reparationchlorinateur/gree-bridge/docs/captures/protocol_b_defrost.txt

# Protocol B (1200 baud 8E1): a whole defrost cycle, Willis MGW12KCH15S/I (made by Gree), heating at Heat 26,
# about -2 C outside, 2026-11-13. Bridge RX tap (BusLog 1), one line when a watched byte changed or every ~15 s.
# Columns: time, outdoor 31 10 frame, indoor 31 20 frame, outdoor 32 10 frame (all 20 bytes, last byte = sum).
#
# Normal heat just before (08:13, from the board's "Out" field, b3..b18 of 31 10):
#   14 58 00 00 24 00 00 5C 00 26 20 86 00 00 09 00   (88 Hz, outdoor air -2, outdoor coil -8, discharge 94, b15 00, b17 09)
#   indoor fan 4, indoor coil 35 C, indoor b12 0A
#
# Defrost was already running when the capture started (08:28 the board showed b15 = 02 and a falling indoor coil).
# What marks it:  outdoor b15 = 02 from the start of defrost until the compressor restarts in heat;
#                 indoor coil falls below 0 (down to -19 C: reversed cycle), indoor fan b4 = 00, indoor b12 = 00;
#                 outdoor coil warms from -8 to +16 C while the compressor holds 85 Hz; the outdoor "air" byte
#                 reads up to +17 C (its sensor is warmed by the coil), b17 falls to 3-6 then 0.
# End: 08:32:35 compressor stops (b3 04, b15 still 02), 08:34:07 indoor b12 back to 08, 08:34:26 compressor
#      restarts in heat at 33 Hz with b15 = 00, 08:36:07 indoor fan back on (coil 16 C), b12 0A.
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
08:36:11  31 10 00 14 21 00 00 0C 00 00 50 00 2B 27 5E 00 00 02 00 84  31 20 00 14 01 00 42 3C 00 39 07 00 0A 00 00 00 00 00 00 2E  32 10 00 00 00 00 00 00 00 00 00 00 46 00 00 28 28 28 28 28
