reparationchlorinateur/gree-bridge/docs/images/willis_mgw12kch15s_label.jpg

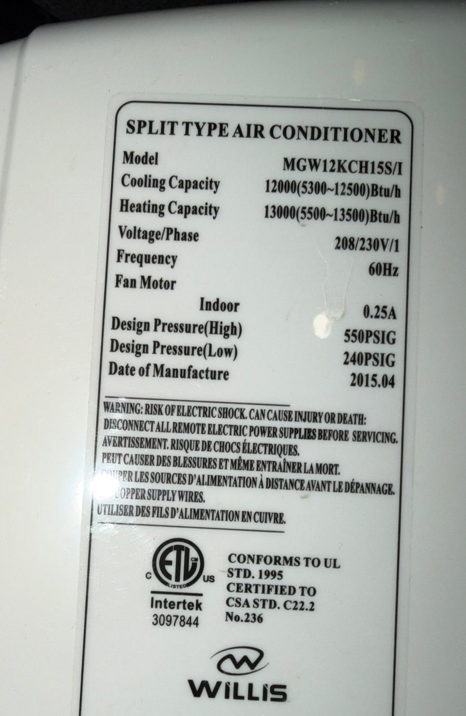
docs/images/willis_mgw12kch15s_label.jpg
