reparationchlorinateur/gree-bridge/hardware/case/out/png/gree_base_top_board.png

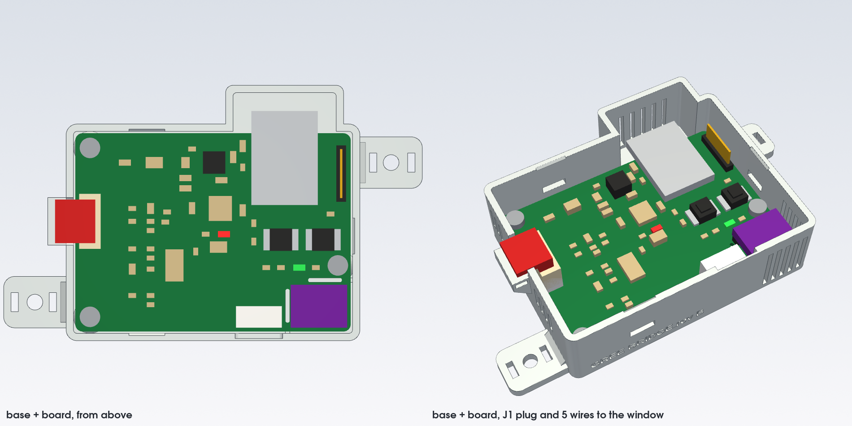
hardware/case/out/png/gree_base_top_board.png
