reparationchlorinateur/gree-bridge/hardware/case/out/png/gree_case_exploded.png

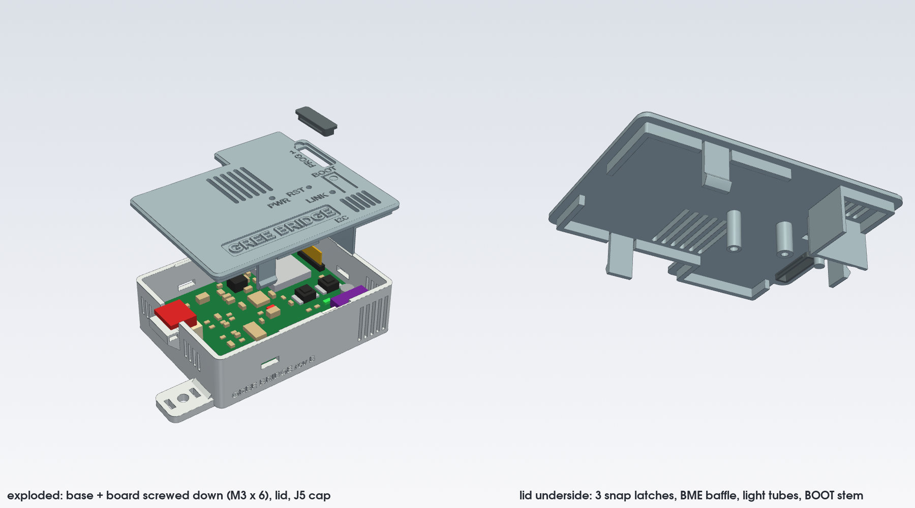
hardware/case/out/png/gree_case_exploded.png
