reparationchlorinateur/gree-bridge/hardware/case/out/png/gree_latch.png

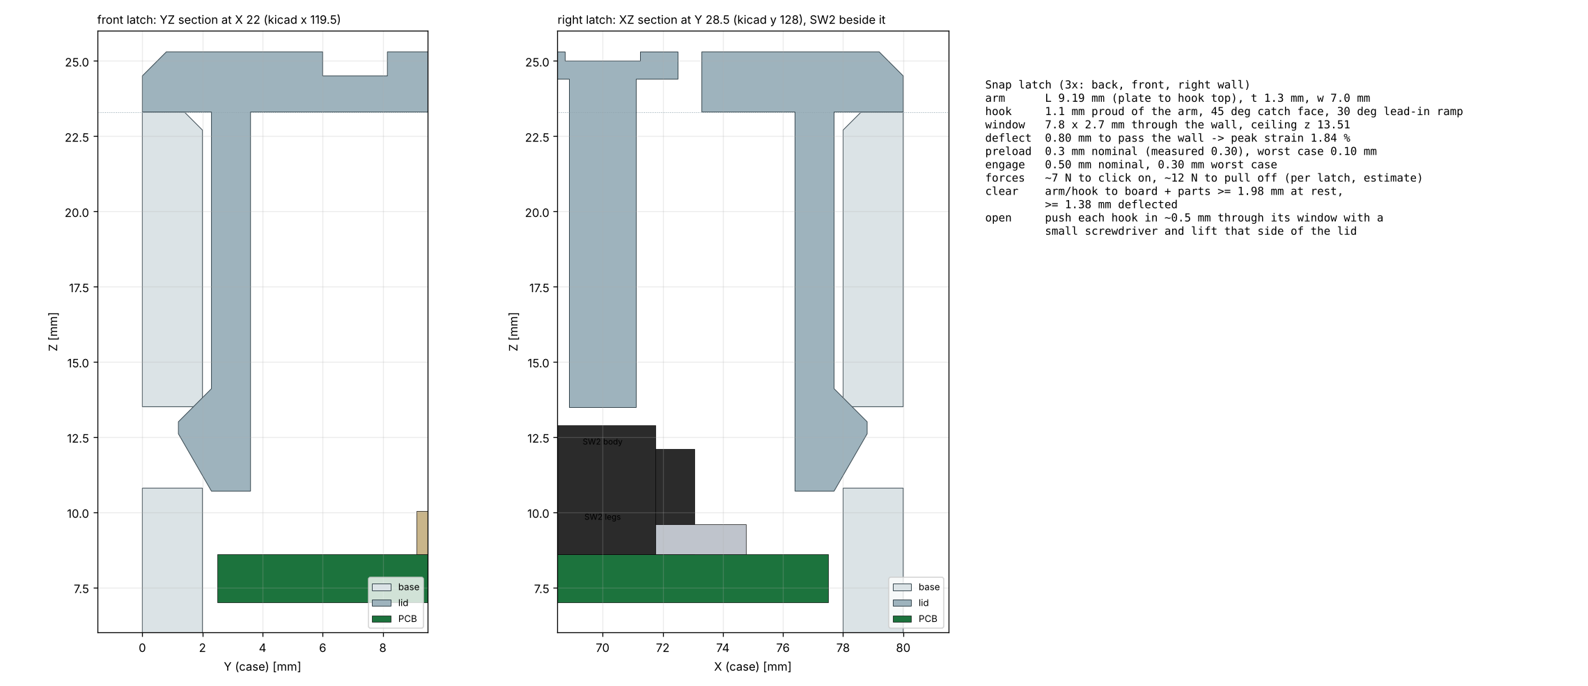
hardware/case/out/png/gree_latch.png
