reparationchlorinateur/gree-bridge/hardware/case/out/png/gree_latch_closeup.png

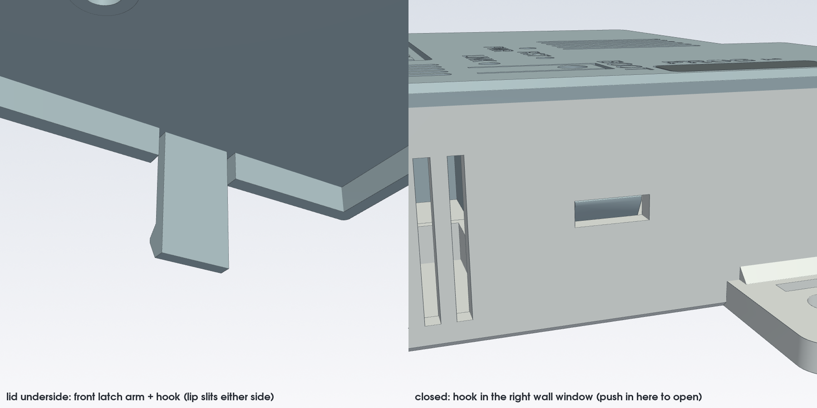
hardware/case/out/png/gree_latch_closeup.png
