reparationchlorinateur/gree-bridge/hardware/case/out/png/gree_lid_top.png

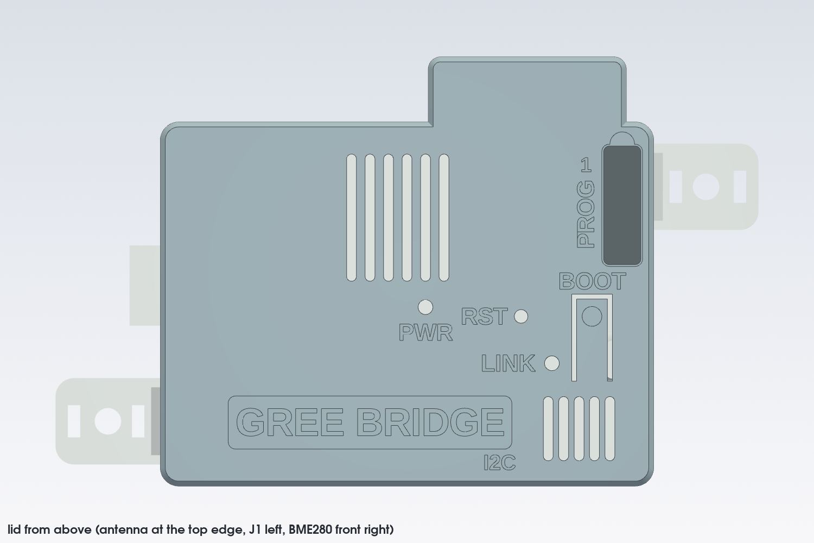
hardware/case/out/png/gree_lid_top.png
