reparationchlorinateur/gree-bridge/hardware/case/out/png/gree_section.png

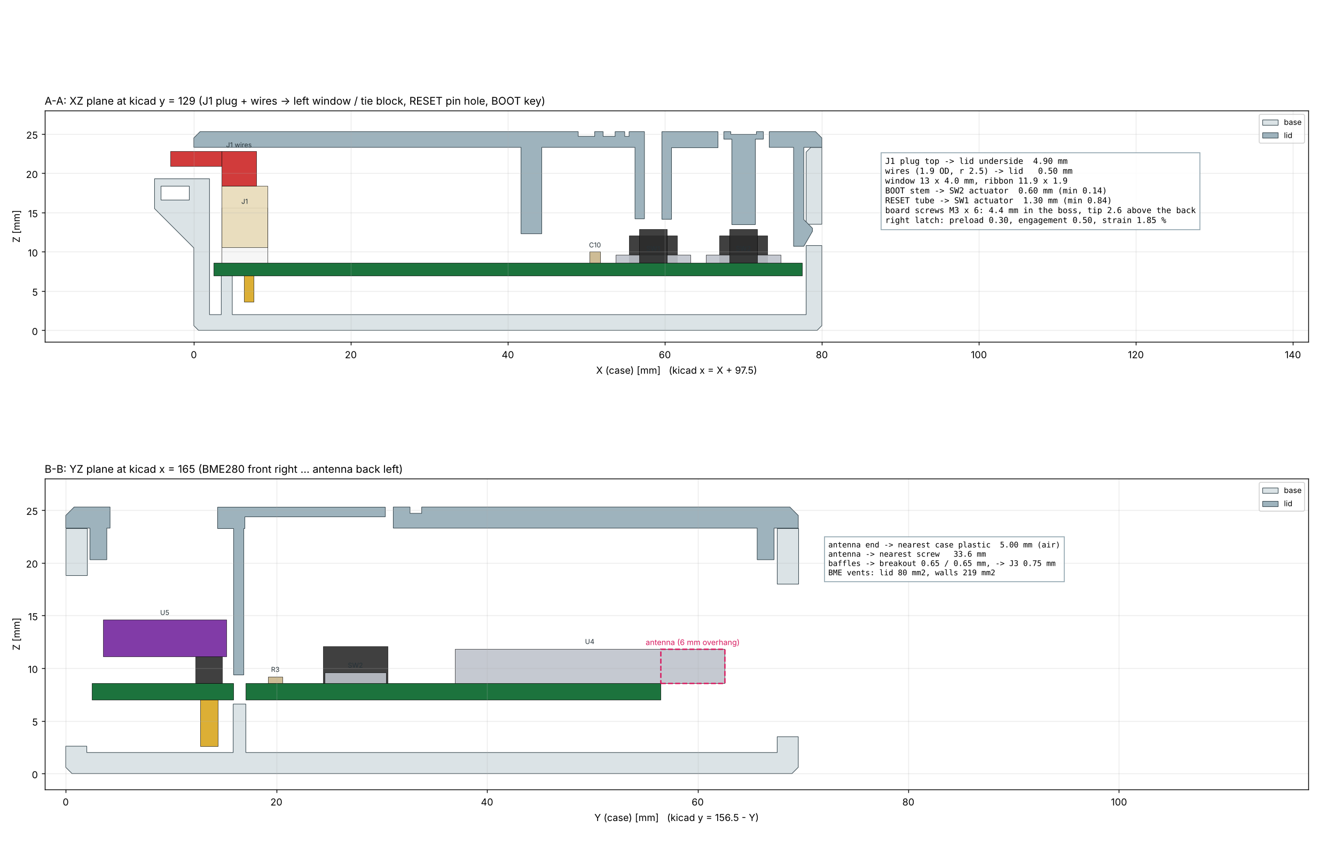
hardware/case/out/png/gree_section.png
