reparationchlorinateur/gree-bridge/hardware/bom.csv

Line | References | Qty per board | Value | Description | Manufacturer | Mfr part # | Mouser # | LCSC # (JLCPCB) | JLCPCB part | KiCad footprint | Notes
1 | C1 C2 C6 | 3 | 10uF 25V | MLCC 10 uF 25 V X7R 1206 | YAGEO | CC1206KKX7R8BB106 | 603-CC126KKX7R8BB106 | C14860 | 10uF 25V X7R 1206 Samsung CL31B106KAHNNNE [SUBSTITUTE] | Capacitor_SMD:C_1206_3216Metric_Pad1.33x1.80mm_HandSolder
2 | C3 C9 C11 | 3 | 100nF | MLCC 100 nF 50 V X7R 0805 | YAGEO | CC0805KRX7R9BB104 | 603-CC805KRX7R9BB104 | C49678 | 100nF 50V X7R 0805 YAGEO CC0805KRX7R9BB104 | Capacitor_SMD:C_0805_2012Metric_Pad1.18x1.45mm_HandSolder
3 | C4 C5 C7 C8 | 4 | 22uF 25V | MLCC 22 uF 25 V X5R 1206 | TDK | C3216X5R1E226M160AB | 810-C3216X5R1E226M | C12891 | 22uF 25V X5R 1206 Samsung CL31A226KAHNNNE [SUBSTITUTE] | Capacitor_SMD:C_1206_3216Metric_Pad1.33x1.80mm_HandSolder | 25 V part keeps more of its capacitance at 5 V than a 10 V one
4 | C10 | 1 | 1uF | MLCC 1 uF 25 V X7R 0805 | YAGEO | CC0805KKX7R8BB105 | 603-CC805KKX7R8BB105 | C28323 | 1uF 50V X7R 0805 Samsung CL21B105KBFNNNE [SUBSTITUTE] | Capacitor_SMD:C_0805_2012Metric_Pad1.18x1.45mm_HandSolder
5 | C12 C13 C14 | 3 | 100pF | MLCC 100 pF 50 V C0G 0805 | YAGEO | CC0805JRNPO9BN101 | 603-CC805JRNPO9BN101 | C1790 | 100pF 50V C0G 0805 Samsung CL21C101JBANNNC [SUBSTITUTE] | Capacitor_SMD:C_0805_2012Metric_Pad1.18x1.45mm_HandSolder
6 | D1 D2 | 2 | SS14 | Schottky diode 40 V 1 A, SMA | onsemi | SS14 | 512-SS14 | C2480 | SS14 40V 1A SMA MDD SS14 [SUBSTITUTE] | Diode_SMD:D_SMA_Handsoldering
7 | D3 | 1 | GREEN | LED green (AlInGaP, 35 mcd), 1206 (status) | Lite-On | LTST-C150KGKT | 859-LTST-C150KGKT | C125085 | LED green 1206 Lite-On LTST-C150KGKT | LED_SMD:LED_1206_3216Metric_Pad1.42x1.75mm_HandSolder | Brighter AlInGaP green; about 1.5 mA from GPIO21 through R3 (1k)
8 | D4 | 1 | RED | LED red, 1206 (power) | Lite-On | LTST-C150KRKT | 859-LTST-C150KRKT | C125086 | LED red 1206 Lite-On LTST-C150KRKT | LED_SMD:LED_1206_3216Metric_Pad1.42x1.75mm_HandSolder
9 | F1 | 1 | 0.5A 24V | PTC resettable fuse 0.5 A hold, 24 V max, 1206 | Bel Fuse | 0ZCJ0050AF2E | 530-0ZCJ0050AF2E | C883126 | PTC 0.5A hold 1A trip 1206 BHFUSE BSMD1206-050-30V [SUBSTITUTE] | Fuse:Fuse_1206_3216Metric_Pad1.42x1.75mm_HandSolder | 24 V rated for the 12 V rail (the 6 V 1206L050YR of the first draft was not)
10 | J1 | 1 | GREE | JST XH 5-pin vertical through-hole header, 2.50 mm (to the Gree board) | JST | B5B-XH-A(LF)(SN) | 306-B5BXHALFSN | C157991 | JST XH 5-pin vertical (THT) JST B5B-XH-A(LF)(SN) [THT - hand-solder or JLC THT option] | Connector_JST:JST_XH_B5B-XH-A_1x05_P2.50mm_Vertical
11 | J3 | 1 | I2C_EXT | JST XH 4-pin vertical through-hole header, 2.50 mm (I2C port for more sensors) | JST | B4B-XH-A(LF)(SN) | 306-B4BXHALFSN | C144395 | JST XH 4-pin vertical (THT) JST B4B-XH-A(LF)(SN) [THT - hand-solder or JLC THT option] | Connector_JST:JST_XH_B4B-XH-A_1x04_P2.50mm_Vertical
12 | J5 | 1 | PROG | Pin header 1x6 2.54 mm, straight, through-hole, gold (programming) | Wurth Elektronik | 61300611121 | 710-61300611121 | C5444523 | Pin header 1x6 2.54mm (THT) Wurth 61300611121 [THT - hand-solder or JLC THT option] | Connector_PinHeader_2.54mm:PinHeader_1x06_P2.54mm_Vertical | Plain straight header (6 mm mating pins, 3 mm solder tails); replaces the alternating-leg SMD header
13 | L1 | 1 | 4.7uH | Inductor 4.7 uH +/-20%, 27 mOhm, Isat 5.8 A, shielded 6 x 6 x 4.5 mm | TDK | VLS6045EX-4R7M | 810-VLS6045EX-4R7M | C307880 | 4.7uH 5.8A 6x6x4.5 TDK VLS6045EX-4R7M | Inductor_SMD:L_Bourns_SRN6045TA | Replaces Bourns SRN6045TA-4R7M (0 in stock on 2026-10-08); fits the same pads, no PCB change. The Bourns part still fits if you prefer it
14 | Q1 | 1 | BSS138 | N-MOSFET 50 V, SOT-23 (IR transmit) | onsemi | BSS138 | 512-BSS138 | C52895 | BSS138 SOT-23 onsemi BSS138 | Package_TO_SOT_SMD:SOT-23
15 | Q2 | 1 | BC847C | NPN 45 V 100 mA, SOT-23, hFE 420-800 (RX level stage) | onsemi | BC847CLT1G | 863-BC847CLT1G | C150094 | BC847C SOT-23 onsemi BC847CLT1G | Package_TO_SOT_SMD:SOT-23 | New in rev B: lets J1-3 take the low-voltage U6 opto output
16 | R1 R2 | 2 | 10k | Resistor 10k 1% 1/8 W 0805 | YAGEO | RC0805FR-0710KL | 603-RC0805FR-0710KL | C17414 | 10k 1% 0805 UNI-ROYAL 0805W8F1002T5E [SUBSTITUTE] | Resistor_SMD:R_0805_2012Metric_Pad1.20x1.40mm_HandSolder
17 | R3 R5 R12 | 3 | 1k | Resistor 1k 1% 1/8 W 0805 | YAGEO | RC0805FR-071KL | 603-RC0805FR-071KL | C17513 | 1k 1% 0805 UNI-ROYAL 0805W8F1001T5E [SUBSTITUTE] | Resistor_SMD:R_0805_2012Metric_Pad1.20x1.40mm_HandSolder
18 | R4 R14 R15 | 3 | 4.7k | Resistor 4.7k 1% 1/8 W 0805 | YAGEO | RC0805FR-074K7L | 603-RC0805FR-074K7L | C17673 | 4.7k 1% 0805 UNI-ROYAL 0805W8F4701T5E [SUBSTITUTE] | Resistor_SMD:R_0805_2012Metric_Pad1.20x1.40mm_HandSolder
19 | R6 R11 R13 | 3 | 1M | Resistor 1M 1% 1/8 W 0805 | YAGEO | RC0805FR-071ML | 603-RC0805FR-071ML | C17514 | 1M 1% 0805 UNI-ROYAL 0805W8F1004T5E [SUBSTITUTE] | Resistor_SMD:R_0805_2012Metric_Pad1.20x1.40mm_HandSolder
20 | R7 | 1 | 220 | Resistor 220 1% 1/8 W 0805 | YAGEO | RC0805FR-07220RL | 603-RC0805FR-07220RL | C17557 | 220 1% 0805 UNI-ROYAL 0805W8F2200T5E [SUBSTITUTE] | Resistor_SMD:R_0805_2012Metric_Pad1.20x1.40mm_HandSolder
21 | R8 | 1 | 100 | Resistor 100 1% 1/8 W 0805 | YAGEO | RC0805FR-07100RL | 603-RC0805FR-07100RL | C17408 | 100 1% 0805 UNI-ROYAL 0805W8F1000T5E [SUBSTITUTE] | Resistor_SMD:R_0805_2012Metric_Pad1.20x1.40mm_HandSolder
22 | R9 | 1 | 100k | Resistor 100k 1% 1/8 W 0805 | YAGEO | RC0805FR-07100KL | 603-RC0805FR-07100KL | C149504 | 100k 1% 0805 UNI-ROYAL 0805W8F1003T5E [SUBSTITUTE] | Resistor_SMD:R_0805_2012Metric_Pad1.20x1.40mm_HandSolder
23 | R10 | 1 | 47k | Resistor 47k 1% 1/8 W 0805 | YAGEO | RC0805FR-0747KL | 603-RC0805FR-0747KL | C17713 | 47k 1% 0805 UNI-ROYAL 0805W8F4702T5E [SUBSTITUTE] | Resistor_SMD:R_0805_2012Metric_Pad1.20x1.40mm_HandSolder | R10 is 47k now (was 1k): base resistor of Q2
24 | R16 | 1 | 22k | Resistor 22k 1% 1/8 W 0805 | YAGEO | RC0805FR-0722KL | 603-RC0805FR-0722KL | C17560 | 22k 1% 0805 UNI-ROYAL 0805W8F2202T5E [SUBSTITUTE] | Resistor_SMD:R_0805_2012Metric_Pad1.20x1.40mm_HandSolder | R16: Q2 collector pull-up
25 | SW1 SW2 | 2 | RESET / BOOT | Tact switch 6 x 6 mm SMD gull-wing, 4.3 mm, 1.3 N | C&K | PTS645SL43SMTR92 LFS | 611-PTS645SL43SMTR92 | C221880 | Tact 6x6 SMD 4.3mm C&K PTS645SM43SMTR92LFS [SUBSTITUTE] | Button_Switch_SMD:SW_SPST_PTS645 | SL = 1.3 N version of the PTS645SM43 (1.6 N, restricted availability); same footprint
26 | U1 | 1 | AP63205WU-7 | Buck regulator 5 V 2 A, TSOT-23-6 | Diodes Incorporated | AP63205WU-7 | 621-AP63205WU-7 | C2071056 | AP63205WU-7 buck 5V 2A Diodes Inc AP63205WU-7 | Package_TO_SOT_SMD:TSOT-23-6
27 | U2 | 1 | AP2114H-3.3TRG1 | LDO 3.3 V 1 A, SOT-223 | Diodes Incorporated | AP2114H-3.3TRG1 | 621-AP2114H-3.3TRG1 | C150716 | AP2114H-3.3TRG1 LDO Diodes Inc AP2114H-3.3TRG1 | Package_TO_SOT_SMD:SOT-223-3_TabPin2
28 | U3 | 1 | 74LVC14AD | Hex Schmitt-trigger inverter, SOIC-14 | Texas Instruments | SN74LVC14ADRG4 | 595-SN74LVC14ADRG4 | C133541 | SN74LVC14A SOIC-14 TI SN74LVC14ADR [ORDERABLE VARIANT] | Package_SO:SOIC-14_3.9x8.7mm_P1.27mm | Same TI part as SN74LVC14ADR (G4 = green package code); the plain ADR was on order only
29 | U4 | 1 | ESP32-S3-WROOM-1-N16R8 | ESP32-S3 module, 16 MB flash, 8 MB PSRAM | Espressif | ESP32-S3-WROOM-1-N16R8 | 356-ESP32S3WRM1N16R8 | C2913202 | ESP32-S3-WROOM-1-N16R8 Espressif ESP32-S3-WROOM-1-N16R8 | RF_Module:ESP32-S3-WROOM-1
30 | U5 | 1 | GY-BME280 | BME280 breakout module, 6-pin (VCC GND SCL SDA CSB SDO), 3.3 V version | generic | GY-BME280 |  |  |  | GreeBridge:BME280_Module_GY_1x06_P2.54mm | Not a JLCPCB part: plug-in breakout on a 1x6 header, chip side up; address 0x76
