reparationchlorinateur/gree-bridge/hardware/case/out/step/gree_case_assembly.step

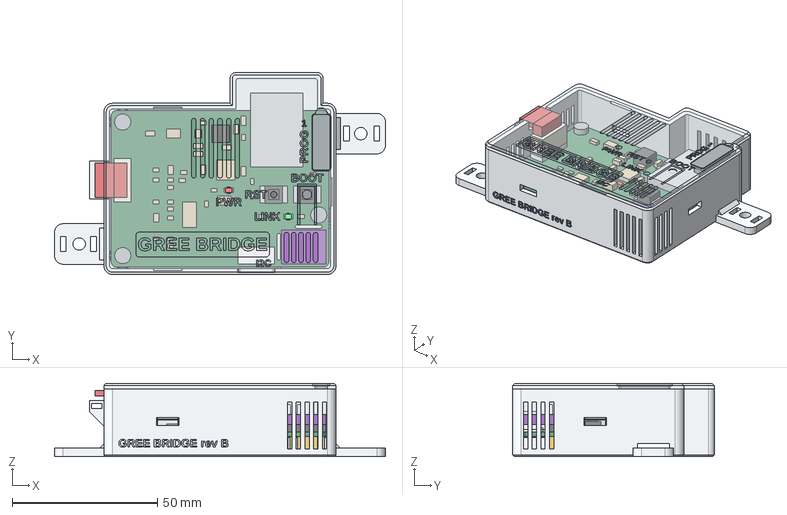
[picture p15: CAD file, 2026-10-18]
hardware/case/out/step/gree_case_assembly.step
114.0 x 69.5 x 25.3 mm
base
lid
j5_cap
pcb
M3x6_H1
M3x6_H2
M3x6_H3
C1_C_1206
C10_C_0805
C11_C_0805
C12_C_0805
C13_C_0805
C14_C_0805
C2_C_1206
C3_C_0805
C4_C_1206
C5_C_1206
C6_C_1206
C7_C_1206
C8_C_1206
C9_C_0805
D1_D_SMA
D2_D_SMA
D3_LED_1206
D4_LED_1206
F1_Fuse_1206
Q1_SOT-23
Q2_SOT-23
R1_R_0805
R10_R_0805
R11_R_0805
R12_R_0805
R13_R_0805
R14_R_0805
R15_R_0805
R16_R_0805
R2_R_0805
R3_R_0805
R4_R_0805
R5_R_0805
R6_R_0805
R7_R_0805
R8_R_0805
R9_R_0805
U1_TSOT-23-6
U2_SOT-223
U3_SOIC-14
L1_inductor
U4_module
SW1_switch_body
SW1_switch_legs
SW1_switch_actuator
SW2_switch_body
SW2_switch_legs
SW2_switch_actuator
J1_xh_header
J1_xhp_plug
J3_xh_header
J5_header_body
J5_header_pins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
