reparationchlorinateur/gree-bridge/hardware/case/out/step/gree_lid.step

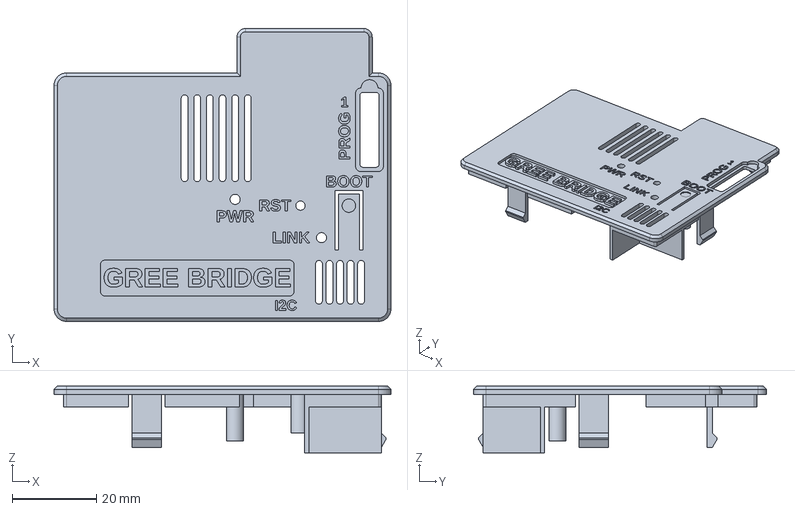
[picture p16: CAD file, 2026-10-18]
hardware/case/out/step/gree_lid.step
80.0 x 69.5 x 15.9 mm
