reparationchlorinateur/gree-bridge/hardware/case/out/step/gree_base.step

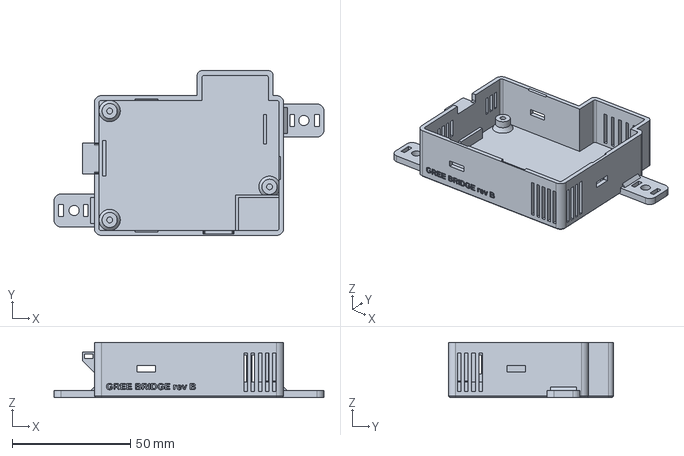
[picture p17: CAD file, 2026-10-18]
hardware/case/out/step/gree_base.step
114.0 x 69.5 x 23.3 mm
