reparationchlorinateur/gree-bridge/hardware/case/out/step/gree_cap.step

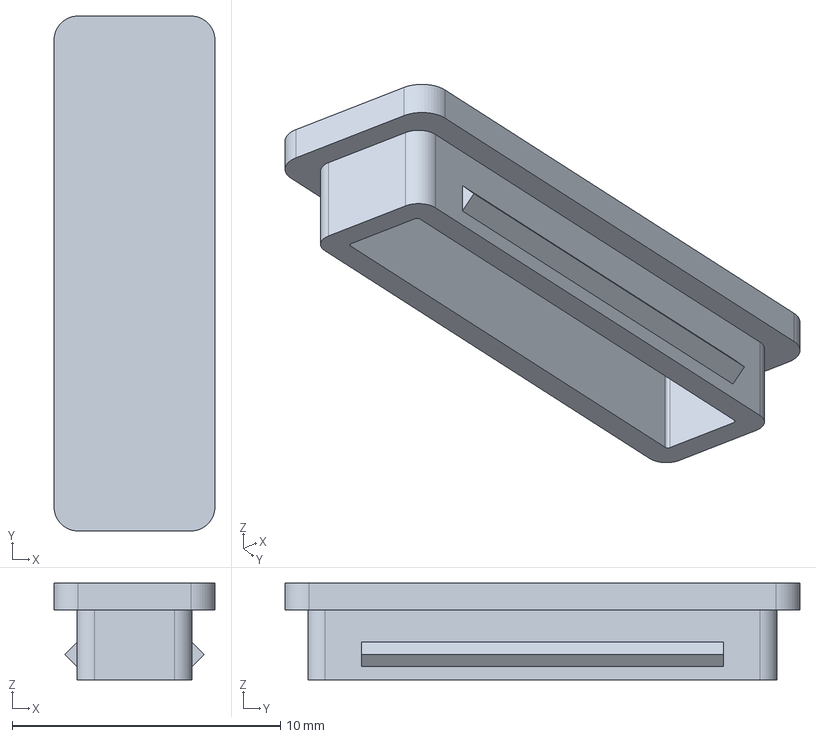
[picture p18: CAD file, 2026-10-18]
hardware/case/out/step/gree_cap.step
6.00 x 19.2 x 3.60 mm
