reparationchlorinateur/gree-bridge/hardware/case/gree_case_params.scad

// generated by layout_gree.py from gree_bridge.kicad_pcb - do not edit by hand (edit the DESIGN knobs there)
// case frame: X = kicad_x - 97.5, Y = 156.5 - kicad_y, Z = 0 at the base bottom
wall = 2;
floor_t = 2;
lid_t = 2;
fit = 0.3;
board_gap = 0.5;
ant_air = 5;
under_gap = 5;
lid_air = 14.7;
seam = 0;
lip_t = 1.6;
lip_h = 3;
r_out = 3;
r_bump = 2;
r_in = 1;
cham_bot = 0.6;
cham_top = 0.8;
screw_len = 6;
head_d = 5.6;
head_h = 2.4;
pilot_d = 2.5;
pilot_bottom = 1;
insert_d = 4;
insert_depth = 5;
insert_len = 4;
boss_d_insert = 7.4;
head_relief = 1.05;
boss_d = 6.4;
boss_flare_d = 9;
boss_flare_h = 2;
led_hole_d = 2.4;
led_tube_od = 4;
led_tube_gap = 2.5;
led_skin = 0;
rst_hole_d = 2.2;
rst_tube_od = 4.6;
rst_tube_gap = 1.3;
boot_w = 5;
boot_t = 0.9;
boot_slot = 0.8;
boot_arm = 10.5;
boot_tip_over = 2.8;
stem_d = 3;
stem_gap = 0.6;
tol_pcb = 0.16;
tol_base = 0.1;
tol_lid = 0.1;
tol_switch = 0.1;
sw_travel = 0.25;
sw_overtravel = 0.15;
latch_w = 7;
latch_t = 1.3;
latch_slit = 0.8;
latch_hook = 1.1;
latch_flat = 0.4;
latch_preload = 0.3;
latch_arm_bot = 10.7;
latch_win_side = 0.4;
latch_leadin = 0.6;
j5_recess = 1;
j5_recess_d = 1;
cap_plug_fit = 0.15;
cap_wall = 0.8;
cap_plug_below = 1.6;
cap_bump = 0.45;
win_w = 13;
win_h = 4;
win_r = 1;
tie_depth = 5;
j3_ko_w = 13;
ko_membrane = 0.6;
vent_w = 1.6;
vent_w_bme = 1.5;
ear_len = 17;
ear_w = 14;
ear_t = 3;
ear_hole = 4.3;
ear_gusset = 1.5;
ear_left_ky = 146;
ear_right_ky = 108;
baffle_t = 1;
baffle_gap = 0.8;
rib_gap = 0.4;
label_size = 4.6;
label_depth = 0.8;
legend_size = 2.8;
legend_depth = 0.6;
X0 = 97.5;
Y0 = 156.5;
t_pcb = 1.6;
z_pb = 7;
z_pt = 8.6;
z_li = 23.3;
z_wall = 23.3;
z_top = 25.3;
main_o = [0, 0, 80, 59];
bump_o = [43.45, 50, 75.55, 69.55];
main_i = [2, 2, 78, 57];
bump_i = [45.45, 50, 73.55, 67.55];
use_inserts = false;
label = "GREE BRIDGE";
board = [2.5, 2.5, 77.5, 56.5];
antenna = [50.45, 56.5, 68.55, 62.55];
esp_module = [50.45, 36.95, 68.55, 62.55];
holes = [[6.5, 52.5], [6.5, 6.5], [74, 20.5]];
led = [[43, 29], [63.5, 19.9]];
z_led_tube = 12.3;
rst = [58.5, 27.5];
z_rst_tube = 14.2;
boot = [70, 27.5];
boot_tongue = [67.5, 17, 72.5, 30.3];
boot_slots = [[66.7, 17, 67.5, 31.1], [72.5, 17, 73.3, 31.1], [66.7, 30.3, 73.3, 31.1]];
z_stem = 13.5;
screws = [[6.5, 52.5, 2.6, 11], [6.5, 6.5, 2.6, 11], [74, 20.5, 2.6, 11]];
z_head_relief = 12.05;
head_relief_d = 7.7;
j5_open = [72.6, 36.6, 77.2, 54.4];
slotA = [65.9, 15.9, 75.1, 17.1];
slotB = [59.7, 4.9, 60.9, 14.1];
baffleA = [59.5, 15.9, 78, 16.9];
baffleB = [59.5, 2, 60.5, 16.9];
z_baffle = 9.4;
ribA = [59.7, 15.9, 78, 17.1];
ribB = [59.7, 2, 60.9, 16.5];
z_rib = 6.6;
rest_j1 = [3.5, 25, 4.9, 40];
rest_j5 = [71.5, 38.5, 72.7, 51];
win = [26, 39, 19.3, 23.3];
tie = [-5, 26, 0, 39, 19.3];
tie_tunnel = [-4.2, -0.6, 16.6, 18.4];
ko = [46, 59, 19.3, 23.3];
latch_z = [10.7, 13.0053, 13.5053];
latch_win_z = [10.8, 13.5053];
latches = [[0, 22, 57, 1], [0, 22, 2, -1], [1, 28.5, 78, 1]];
lip_cut = [[-1, 24, 4.5, 41], [44, -1, 59.5, 4.5], [70.5, 32.8, 81, 58], [17.7, 54.1, 26.3, 58], [17.7, 1, 26.3, 4.9], [75.1, 24.2, 79, 32.8]];
vent_lid = [[31, 34, 31, 53], [34, 34, 34, 53], [37, 34, 37, 53], [40, 34, 40, 53], [43, 34, 43, 53], [46, 34, 46, 53]];
vent_lid_bme = [[62.9, 4.9, 62.9, 13.7], [65.4, 4.9, 65.4, 13.7], [67.9, 4.9, 67.9, 13.7], [70.4, 4.9, 70.4, 13.7], [72.9, 4.9, 72.9, 13.7]];
vent_right = [4.5, 7.5, 10.5, 13.5];
vent_front = [64, 67, 70, 73, 76];
z_vent_bme = [2.6, 18.8];
vent_left = [53, 50, 47, 22, 19, 16, 13];
vent_back = [51.5, 55.5, 59.5, 63.5, 67.5];
z_vent = [10, 18];
z_vent_back = [3.5, 18];
ear_left = [-17, 3.5, 1, 17.5];
ear_right = [79, 41.5, 97, 55.5];
ear_hole_off = 8.5;
ear_slot_off = [3.6, 14];
ear_slot = [2, 5.2];
label_pocket = [11, 6, 57, 14.6];
label_xy = [34, 10.3];
legends = [["PWR", 43, 24.9, 2.8, 0, "center"], ["LINK", 60.8, 19.9, 2.8, 0, "right"], ["RST", 56.3, 27.5, 2.8, 0, "right"], ["BOOT", 70, 33.2, 2.8, 0, "center"], ["PROG", 69, 44, 2.8, 90, "center"], ["1", 69, 52.05, 2.4, 0, "center"], ["I2C", 55, 3.8, 2.5, 0, "center"]];
board_outer = [[75.7846, 56.4796], [76.0635, 56.419], [76.3308, 56.3193], [76.5813, 56.1825], [76.8097, 56.0115], [77.0115, 55.8097], [77.1825, 55.5813], [77.3193, 55.3308], [77.419, 55.0635], [77.4796, 54.7846], [77.5, 54.5], [77.5, 4.5], [77.4796, 4.2154], [77.419, 3.9365], [77.3193, 3.6692], [77.1825, 3.4187], [77.0115, 3.1903], [76.8097, 2.9885], [76.5813, 2.8175], [76.3308, 2.6807], [76.0635, 2.581], [75.7846, 2.5204], [75.5, 2.5], [4.5, 2.5], [4.2154, 2.5204], [3.9365, 2.581], [3.6692, 2.6807], [3.4187, 2.8175], [3.1903, 2.9885], [2.9885, 3.1903], [2.8175, 3.4187], [2.6807, 3.6692], [2.581, 3.9365], [2.5204, 4.2154], [2.5, 4.5], [2.5, 54.5], [2.5204, 54.7846], [2.581, 55.0635], [2.6807, 55.3308], [2.8175, 55.5813], [2.9885, 55.8097], [3.1903, 56.0115], [3.4187, 56.1825], [3.6692, 56.3193], [3.9365, 56.419], [4.2154, 56.4796], [4.5, 56.5], [75.5, 56.5]];
board_slots = [[[60.1447, 14.0796], [60, 14.0196], [59.8757, 13.9243], [59.7804, 13.8], [59.7204, 13.6553], [59.7, 13.5], [59.7, 5.5], [59.7204, 5.3447], [59.7804, 5.2], [59.8757, 5.0757], [60, 4.9804], [60.1447, 4.9204], [60.3, 4.9], [60.4553, 4.9204], [60.6, 4.9804], [60.7243, 5.0757], [60.8196, 5.2], [60.8796, 5.3447], [60.9, 5.5], [60.9, 13.5], [60.8796, 13.6553], [60.8196, 13.8], [60.7243, 13.9243], [60.6, 14.0196], [60.4553, 14.0796], [60.3, 14.1]], [[66.3447, 17.0796], [66.2, 17.0196], [66.0757, 16.9243], [65.9804, 16.8], [65.9204, 16.6553], [65.9, 16.5], [65.9204, 16.3447], [65.9804, 16.2], [66.0757, 16.0757], [66.2, 15.9804], [66.3447, 15.9204], [66.5, 15.9], [74.5, 15.9], [74.6553, 15.9204], [74.8, 15.9804], [74.9243, 16.0757], [75.0196, 16.2], [75.0796, 16.3447], [75.1, 16.5], [75.0796, 16.6553], [75.0196, 16.8], [74.9243, 16.9243], [74.8, 17.0196], [74.6553, 17.0796], [74.5, 17.1], [66.5, 17.1]]];
parts = [[[30.85, 43.45, 8.6, 34.15, 45.15, 10.4], "smd"], [[50.425, 25.95, 8.6, 51.775, 28.05, 10.05], "smd"], [[47.425, 46.15, 8.6, 48.775, 48.25, 10.05], "smd"], [[21.95, 29.325, 8.6, 24.05, 30.675, 10.05], "smd"], [[21.95, 21.825, 8.6, 24.05, 23.175, 10.05], "smd"], [[21.95, 9.125, 8.6, 24.05, 10.475, 10.05], "smd"], [[30.85, 40.65, 8.6, 34.15, 42.35, 10.4], "smd"], [[33.25, 51.525, 8.6, 35.35, 52.875, 10.05], "smd"], [[44.65, 48.35, 8.6, 46.35, 51.65, 10.4], "smd"], [[40.65, 42.85, 8.6, 43.95, 44.55, 10.4], "smd"], [[33.45, 34.45, 8.6, 35.15, 37.75, 10.4], "smd"], [[47.25, 33.85, 8.6, 48.95, 37.15, 10.4], "smd"], [[47.25, 51.35, 8.6, 48.95, 54.65, 10.4], "smd"], [[34.625, 23.25, 8.6, 35.975, 25.35, 10.05], "smd"], [[21.65, 46.95, 8.6, 26.35, 50.05, 11.2], "smd"], [[39.15, 23.95, 8.6, 43.85, 27.05, 11.2], "smd"], [[61.85, 19.05, 8.6, 65.15, 20.75, 9.8], "led_g"], [[41.35, 28.15, 8.6, 44.65, 29.85, 9.8], "led_r"], [[14.35, 47.65, 8.6, 17.65, 49.35, 9.9], "smd"], [[22.0625, 34.5, 8.6, 23.9375, 37.5, 9.8], "smd"], [[17.0625, 18, 8.6, 18.9375, 21, 9.8], "smd"], [[50.425, 30.95, 8.6, 51.775, 33.05, 9.2], "smd"], [[16.95, 24.325, 8.6, 19.05, 25.675, 9.2], "smd"], [[21.95, 24.325, 8.6, 24.05, 25.675, 9.2], "smd"], [[16.95, 11.625, 8.6, 19.05, 12.975, 9.2], "smd"], [[21.95, 11.625, 8.6, 24.05, 12.975, 9.2], "smd"], [[53.45, 19.225, 8.6, 55.55, 20.575, 9.2], "smd"], [[57.45, 19.225, 8.6, 59.55, 20.575, 9.2], "smd"], [[21.95, 18.825, 8.6, 24.05, 20.175, 9.2], "smd"], [[70.95, 33.825, 8.6, 73.05, 35.175, 9.2], "smd"], [[66.95, 19.225, 8.6, 69.05, 20.575, 9.2], "smd"], [[36.95, 28.325, 8.6, 39.05, 29.675, 9.2], "smd"], [[16.95, 31.825, 8.6, 19.05, 33.175, 9.2], "smd"], [[21.95, 31.825, 8.6, 24.05, 33.175, 9.2], "smd"], [[16.95, 35.325, 8.6, 19.05, 36.675, 9.2], "smd"], [[26.45, 34.375, 8.6, 28.55, 35.725, 9.2], "smd"], [[25.95, 31.625, 8.6, 28.05, 32.975, 9.2], "smd"], [[31.3625, 47, 8.6, 33.6375, 50, 9.7], "smd"], [[38.85, 32.6, 8.6, 45.15, 39.4, 10.4], "smd"], [[27.025, 16.125, 8.6, 31.975, 24.875, 10.35], "smd"], [[37.25, 45.45, 8.6, 43.35, 51.55, 13.1], "dark"], [[50.45, 36.95, 8.6, 68.55, 62.55, 11.85], "metal"], [[55.45, 24.45, 8.6, 61.55, 30.55, 12.1], "dark"], [[53.74, 24.6, 8.6, 63.26, 30.4, 9.6], "metal"], [[56.75, 25.75, 8.6, 60.25, 29.25, 12.9], "dark"], [[66.95, 24.45, 8.6, 73.05, 30.55, 12.1], "dark"], [[65.24, 24.6, 8.6, 74.76, 30.4, 9.6], "metal"], [[68.25, 25.75, 8.6, 71.75, 29.25, 12.9], "dark"], [[3.55, 25, 8.6, 9.4, 40, 15.6], "white"], [[3.55, 25, 10.6, 9.4, 40, 18.4], "plug"], [[46.25, 3.55, 8.6, 58.75, 9.4, 15.6], "white"], [[46.25, 3.55, 10.6, 58.75, 9.4, 18.4], "plug"], [[73.58, 37.83, 8.6, 76.22, 53.17, 11.14], "dark"], [[74.58, 38.83, 8.6, 75.22, 52.17, 17.14], "gold"], [[61.23, 12.33, 8.6, 76.47, 14.87, 11.1], "dark"], [[61.15, 3.55, 11.1, 76.55, 15.25, 14.6], "bme"], [[3.55, 26.55, 18.4, 7.95, 38.45, 22.8], "wire"], [[-3, 26.55, 20.9, 3.55, 38.45, 22.8], "wire"], [[73.63, 37.88, 11.14, 76.17, 53.12, 25.64], "plug"], [[6.4, 36.9, 3.6, 7.6, 38.1, 7], "gold"], [[6.4, 34.4, 3.6, 7.6, 35.6, 7], "gold"], [[6.4, 31.9, 3.6, 7.6, 33.1, 7], "gold"], [[6.4, 29.4, 3.6, 7.6, 30.6, 7], "gold"], [[6.4, 26.9, 3.6, 7.6, 28.1, 7], "gold"], [[48.15, 6.4, 3.6, 49.35, 7.6, 7], "gold"], [[50.65, 6.4, 3.6, 51.85, 7.6, 7], "gold"], [[53.15, 6.4, 3.6, 54.35, 7.6, 7], "gold"], [[55.65, 6.4, 3.6, 56.85, 7.6, 7], "gold"], [[74.05, 51, 5.3, 75.75, 52.7, 7], "gold"], [[74.05, 48.46, 5.3, 75.75, 50.16, 7], "gold"], [[74.05, 45.92, 5.3, 75.75, 47.62, 7], "gold"], [[74.05, 43.38, 5.3, 75.75, 45.08, 7], "gold"], [[74.05, 40.84, 5.3, 75.75, 42.54, 7], "gold"], [[74.05, 38.3, 5.3, 75.75, 40, 7], "gold"], [[61.65, 12.75, 2.6, 63.35, 14.45, 7], "gold"], [[64.19, 12.75, 2.6, 65.89, 14.45, 7], "gold"], [[66.73, 12.75, 2.6, 68.43, 14.45, 7], "gold"], [[69.27, 12.75, 2.6, 70.97, 14.45, 7], "gold"], [[71.81, 12.75, 2.6, 73.51, 14.45, 7], "gold"], [[74.35, 12.75, 2.6, 76.05, 14.45, 7], "gold"], [[57, 46.29, 6, 59, 48.29, 7], "gold"]];
