reparationchlorinateur/gree-bridge/(list of files, cad)

Other CAD files:
hardware/case/out/stl/gree_base.stl
hardware/case/out/stl/gree_cap.stl
hardware/case/out/stl/gree_lid.stl
