reparationchlorinateur/gree-bridge/hardware/gree_bridge_revB_schematic.pdf

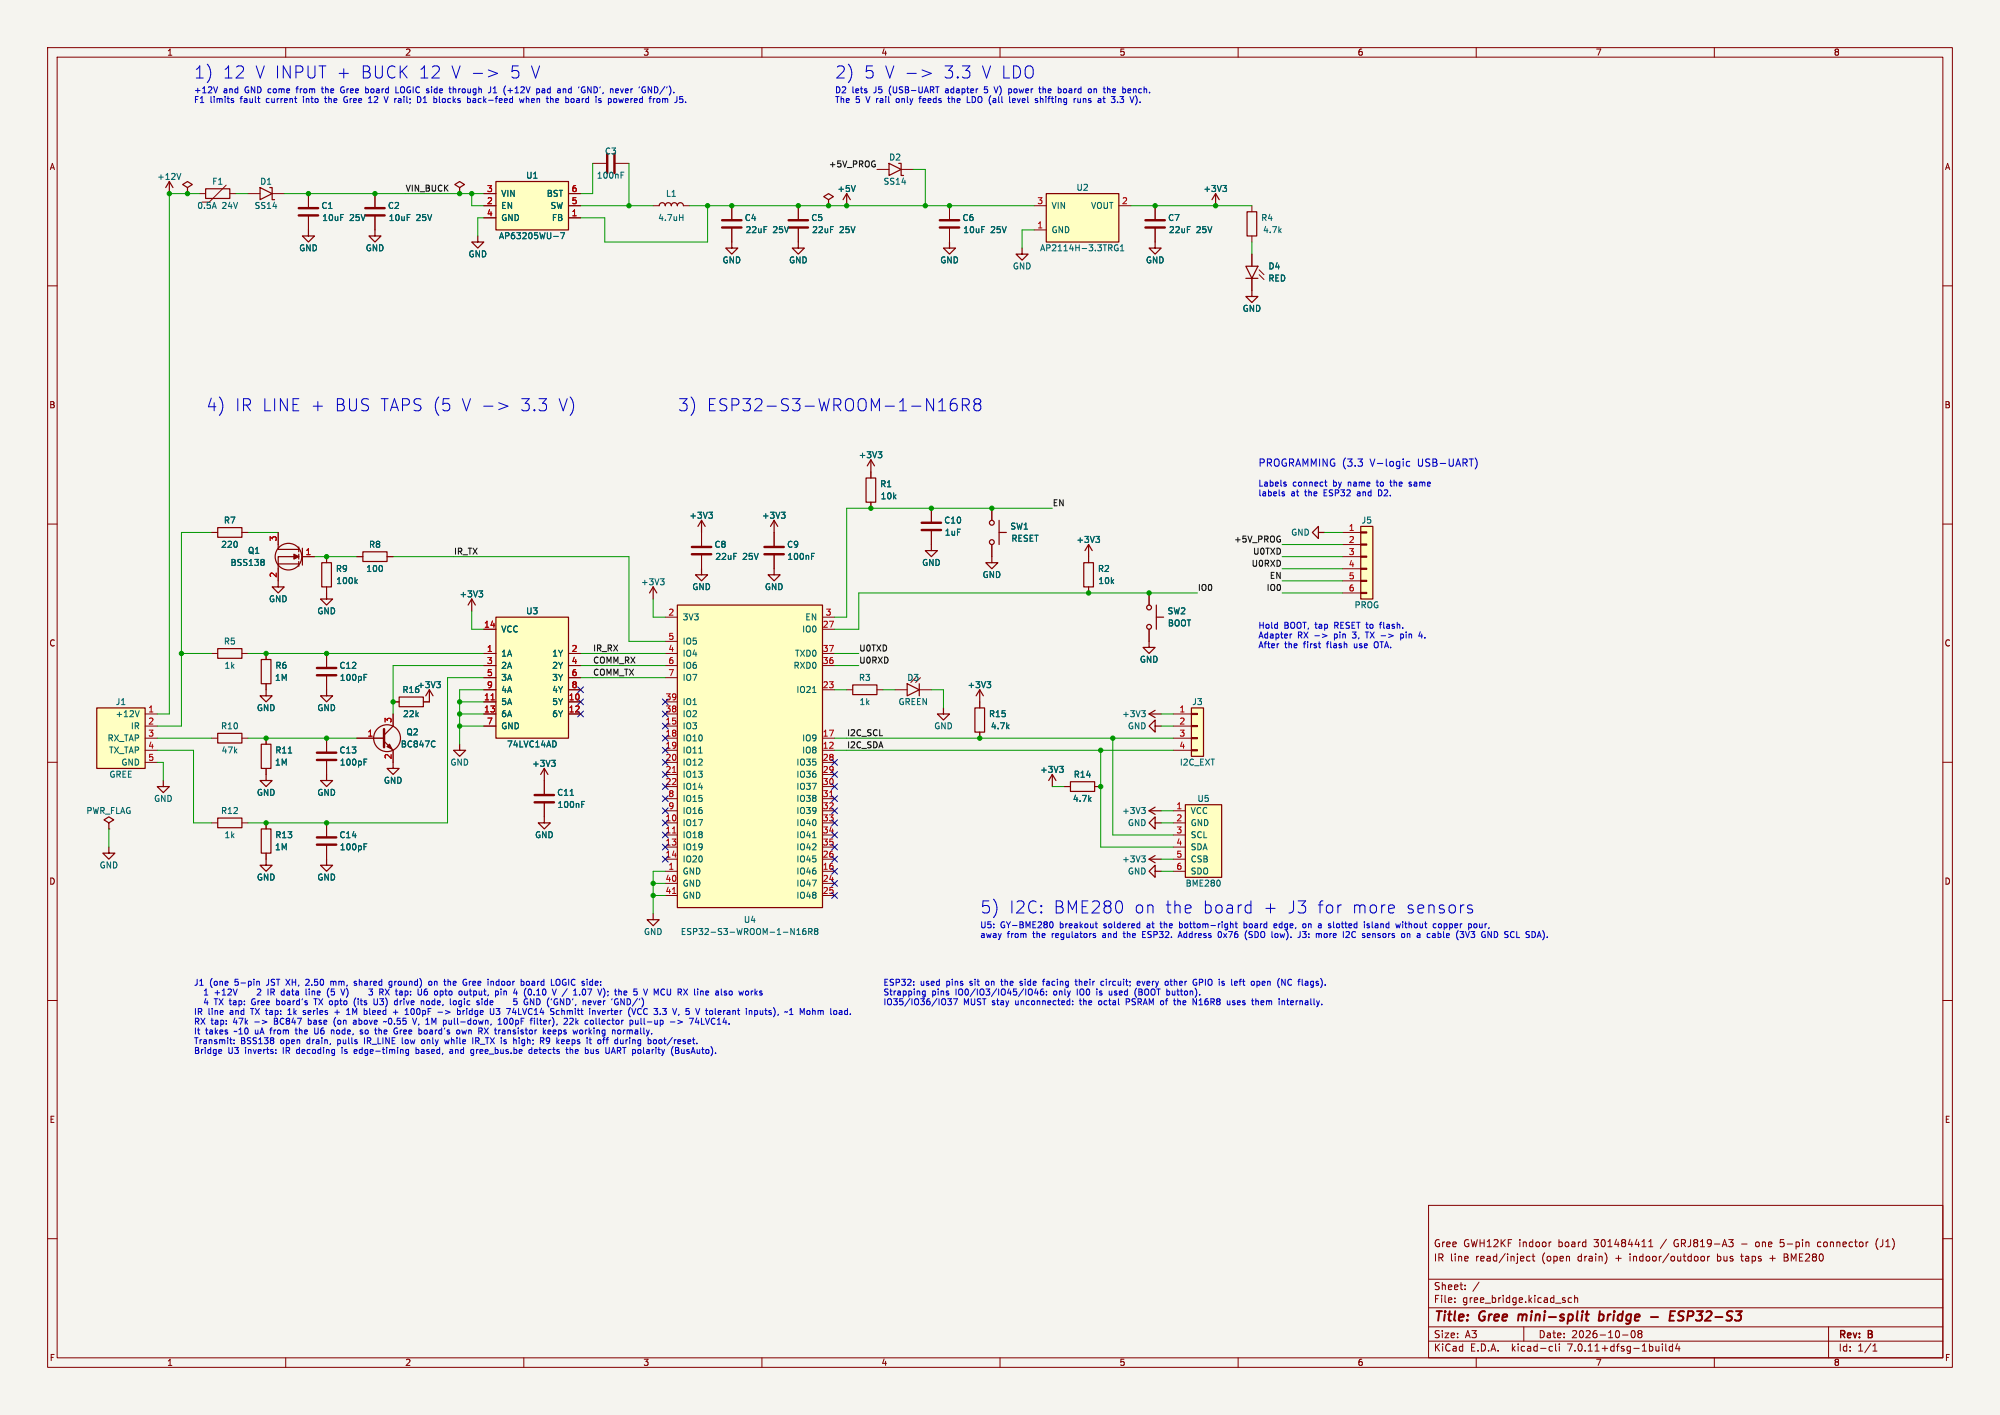
[picture p20: page 1]

Labels connect by name to the same

5) I2C: BME280 on the board + J3 for more sensors
