reparationchlorinateur/gree-bridge/hardware/kicad/gree_bridge.kicad_pcb

## KiCad design hardware/kicad/gree_bridge.kicad_pcb (2026-10-18)

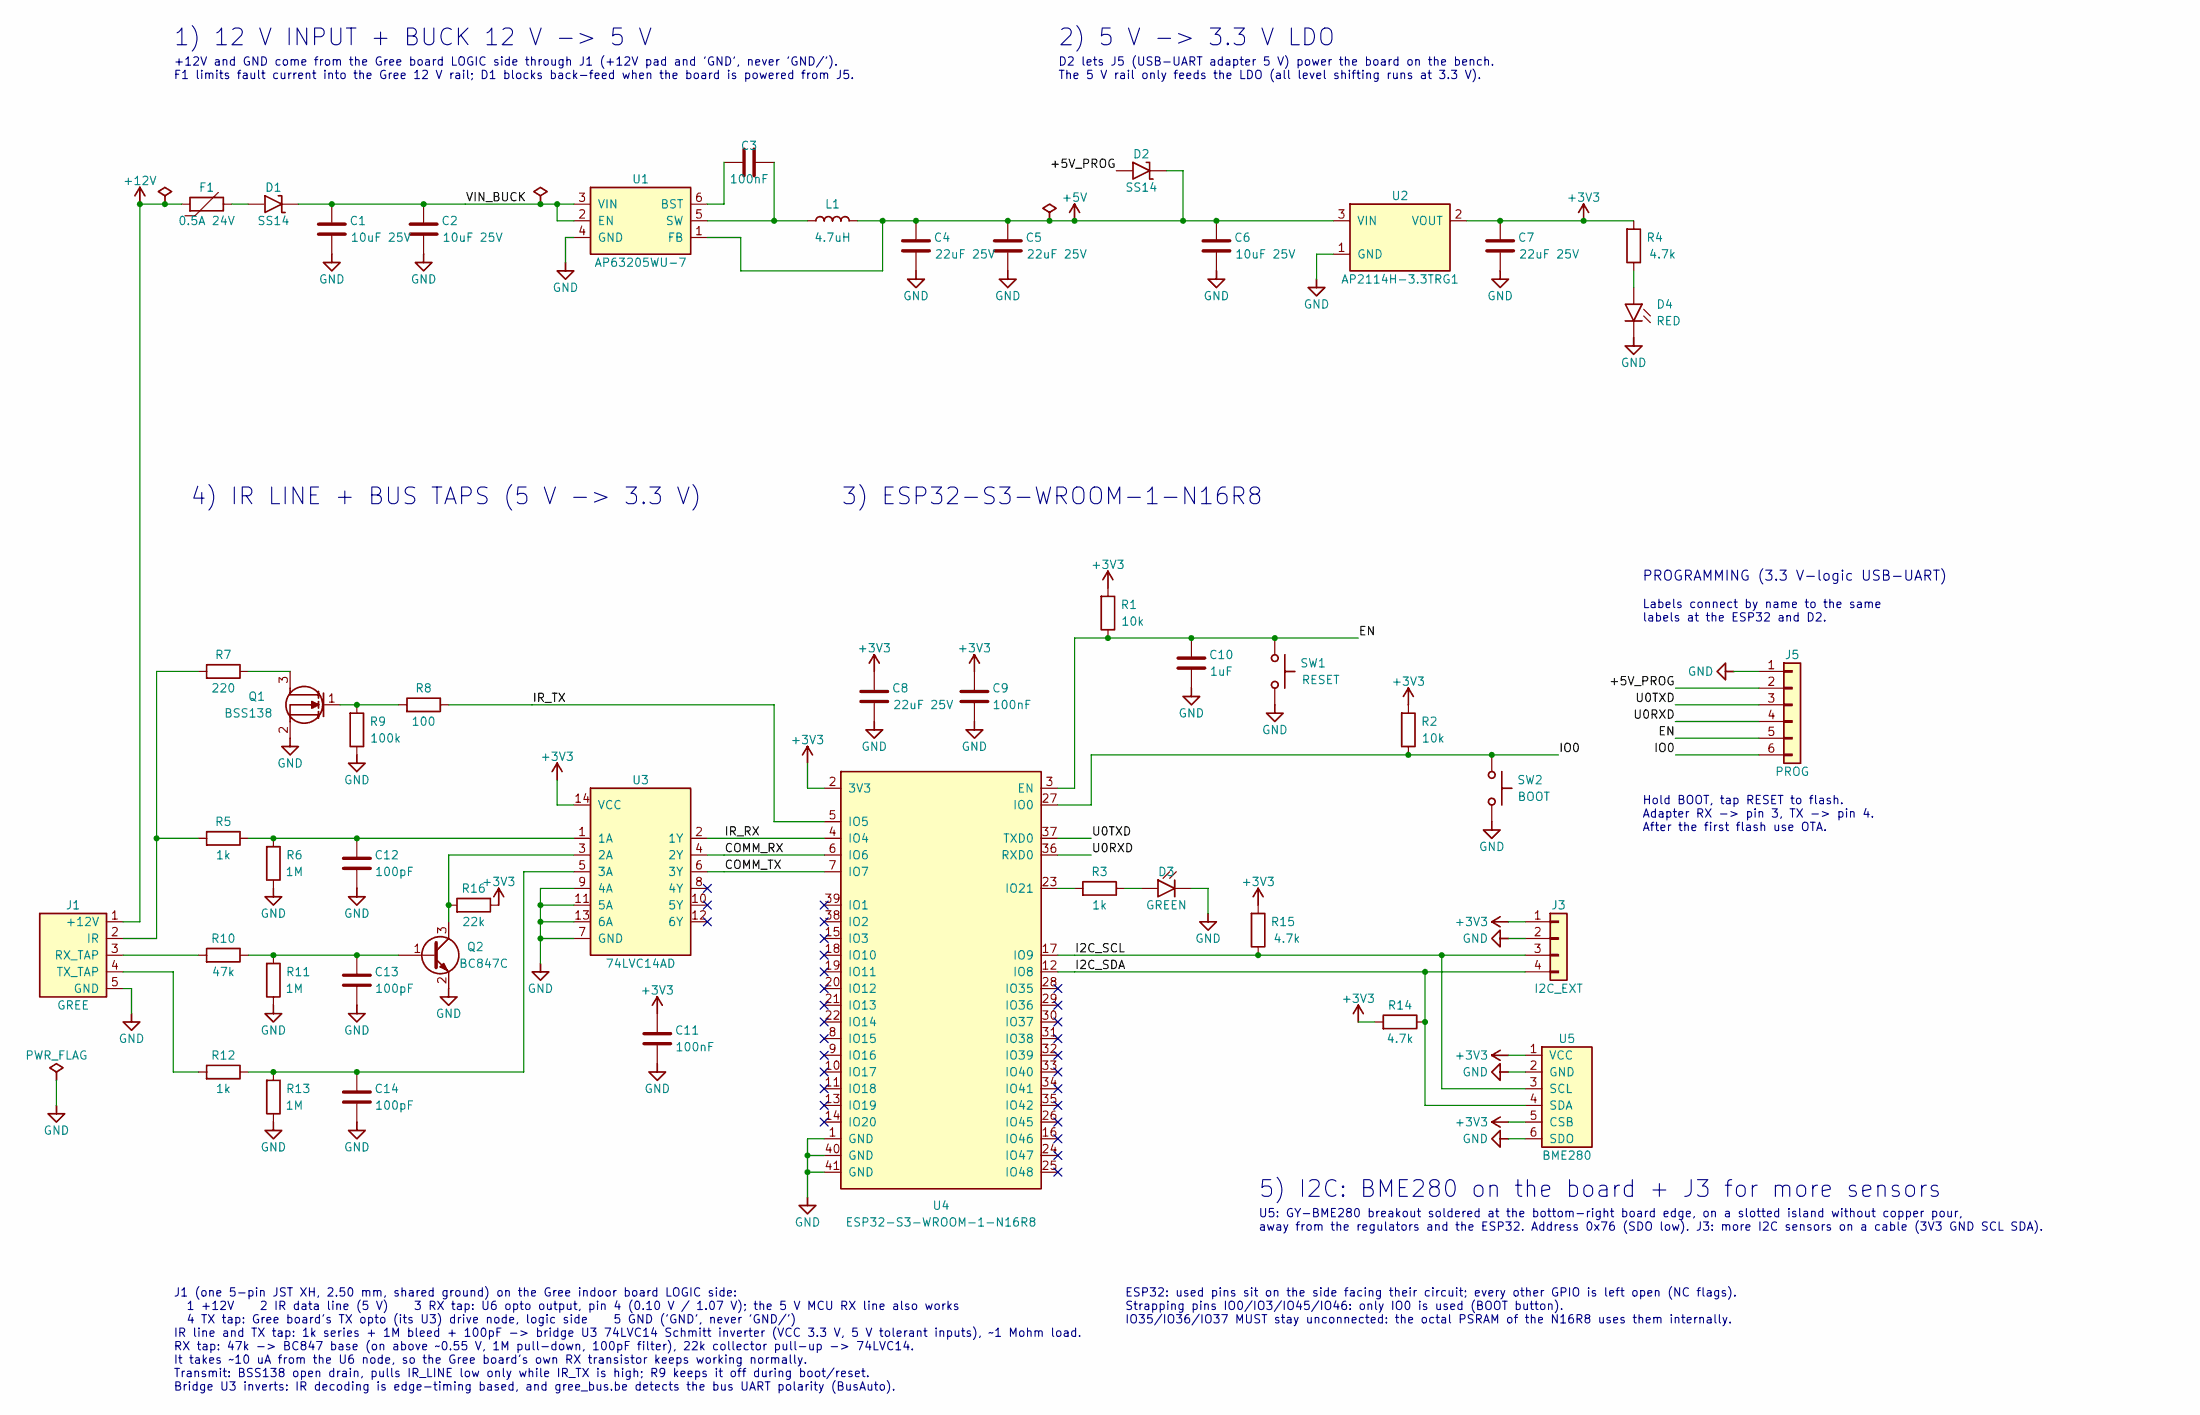
[picture p21: schematic gree_bridge.kicad_sch, Gree mini-split bridge - ESP32-S3]

Parts:
C1, C2, C6: 10uF 25V; C_1206_3216Metric_Pad1.33x1.80mm_HandSolder; MPN CC1206KKX7R8BB106; Mouser 603-CC126KKX7R8BB106
C3, C9, C11: 100nF; C_0805_2012Metric_Pad1.18x1.45mm_HandSolder; MPN CC0805KRX7R9BB104; Mouser 603-CC805KRX7R9BB104
C4, C5, C7, C8: 22uF 25V; C_1206_3216Metric_Pad1.33x1.80mm_HandSolder; MPN C3216X5R1E226M160AB; Mouser 810-C3216X5R1E226M
C10: 1uF; C_0805_2012Metric_Pad1.18x1.45mm_HandSolder; MPN CC0805KKX7R8BB105; Mouser 603-CC805KKX7R8BB105
C12, C13, C14: 100pF; C_0805_2012Metric_Pad1.18x1.45mm_HandSolder; MPN CC0805JRNPO9BN101; Mouser 603-CC805JRNPO9BN101
D1, D2: SS14; D_SMA_Handsoldering; MPN SS14; Mouser 512-SS14
D3: GREEN; LED_1206_3216Metric_Pad1.42x1.75mm_HandSolder; MPN LTST-C150KGKT; Mouser 859-LTST-C150KGKT
D4: RED; LED_1206_3216Metric_Pad1.42x1.75mm_HandSolder; MPN LTST-C150KRKT; Mouser 859-LTST-C150KRKT
F1: 0.5A 24V; Fuse_1206_3216Metric_Pad1.42x1.75mm_HandSolder; MPN 0ZCJ0050AF2E; Mouser 530-0ZCJ0050AF2E
J1: GREE; JST_XH_B5B-XH-A_1x05_P2.50mm_Vertical; MPN B5B-XH-A(LF)(SN); Mouser 306-B5BXHALFSN
J3: I2C_EXT; JST_XH_B4B-XH-A_1x04_P2.50mm_Vertical; MPN B4B-XH-A(LF)(SN); Mouser 306-B4BXHALFSN
J5: PROG; PinHeader_1x06_P2.54mm_Vertical; MPN 61300611121; Mouser 710-61300611121
L1: 4.7uH; L_Bourns_SRN6045TA; MPN VLS6045EX-4R7M; Mouser 810-VLS6045EX-4R7M
Q1: BSS138; SOT-23; MPN BSS138; Mouser 512-BSS138
Q2: BC847C; SOT-23; MPN BC847CLT1G; Mouser 863-BC847CLT1G
R1, R2: 10k; R_0805_2012Metric_Pad1.20x1.40mm_HandSolder; MPN RC0805FR-0710KL; Mouser 603-RC0805FR-0710KL
R3, R5, R12: 1k; R_0805_2012Metric_Pad1.20x1.40mm_HandSolder; MPN RC0805FR-071KL; Mouser 603-RC0805FR-071KL
R4, R14, R15: 4.7k; R_0805_2012Metric_Pad1.20x1.40mm_HandSolder; MPN RC0805FR-074K7L; Mouser 603-RC0805FR-074K7L
R6, R11, R13: 1M; R_0805_2012Metric_Pad1.20x1.40mm_HandSolder; MPN RC0805FR-071ML; Mouser 603-RC0805FR-071ML
R7: 220; R_0805_2012Metric_Pad1.20x1.40mm_HandSolder; MPN RC0805FR-07220RL; Mouser 603-RC0805FR-07220RL
R8: 100; R_0805_2012Metric_Pad1.20x1.40mm_HandSolder; MPN RC0805FR-07100RL; Mouser 603-RC0805FR-07100RL
R9: 100k; R_0805_2012Metric_Pad1.20x1.40mm_HandSolder; MPN RC0805FR-07100KL; Mouser 603-RC0805FR-07100KL
R10: 47k; R_0805_2012Metric_Pad1.20x1.40mm_HandSolder; MPN RC0805FR-0747KL; Mouser 603-RC0805FR-0747KL
R16: 22k; R_0805_2012Metric_Pad1.20x1.40mm_HandSolder; MPN RC0805FR-0722KL; Mouser 603-RC0805FR-0722KL
SW1: RESET; SW_SPST_PTS645; MPN PTS645SL43SMTR92 LFS; Mouser 611-PTS645SL43SMTR92
SW2: BOOT; SW_SPST_PTS645; MPN PTS645SL43SMTR92 LFS; Mouser 611-PTS645SL43SMTR92
U1: AP63205WU-7; TSOT-23-6; MPN AP63205WU-7; Mouser 621-AP63205WU-7
U2: AP2114H-3.3TRG1; SOT-223-3_TabPin2; MPN AP2114H-3.3TRG1; Mouser 621-AP2114H-3.3TRG1
U3: 74LVC14AD; SOIC-14_3.9x8.7mm_P1.27mm; MPN SN74LVC14ADRG4; Mouser 595-SN74LVC14ADRG4
U4: ESP32-S3-WROOM-1-N16R8; ESP32-S3-WROOM-1; MPN ESP32-S3-WROOM-1-N16R8; Mouser 356-ESP32S3WRM1N16R8
U5: BME280; BME280_Module_GY_1x06_P2.54mm; MPN GY-BME280 6-pin breakout

Connections:
+3V3: C7.1, C8.1, C9.1, C11.1, J3.1, R1.1, R2.1, R4.1, R14.1, R15.1, R16.2, U2.2 (VOUT), U3.14 (VCC), U4.2 (3V3), U5.1 (VCC), U5.5 (CSB)
+5V: C4.1, C5.1, C6.1, D2.1 (K), L1.2, U1.1 (FB), U2.3 (VIN)
+12V: F1.1, J1.1 (+12V)
/+5V_PROG: D2.2 (A), J5.2
/COMM_RX: U3.4 (2Y), U4.6 (IO6)
/COMM_TX: U3.6 (3Y), U4.7 (IO7)
/EN: C10.1, J5.5, R1.2, SW1.1, U4.3 (EN)
/I2C_SCL: J3.3, R15.2, U4.17 (IO9), U5.3 (SCL)
/I2C_SDA: J3.4, R14.2, U4.12 (IO8), U5.4 (SDA)
/IO0: J5.6, R2.2, SW2.1, U4.27 (IO0)
/IR_RX: U3.2 (1Y), U4.4 (IO4)
/IR_TX: R8.2, U4.5 (IO5)
/U0RXD: J5.4, U4.36 (RXD0)
/U0TXD: J5.3, U4.37 (TXD0)
/VIN_BUCK: C1.1, C2.1, D1.1 (K), U1.2 (EN), U1.3 (VIN)
GND: C1.2, C2.2, C4.2, C5.2, C6.2, C7.2, C8.2, C9.2, C10.2, C11.2, C12.2, C13.2, C14.2, D3.1 (K), D4.1 (K), J1.5 (GND), J3.2, J5.1, Q1.2 (S), Q2.2 (E), R6.2, R9.2, R11.2, R13.2, SW1.2, SW2.2, U1.4 (GND), U2.1 (GND), U3.7 (GND), U3.9 (4A), U3.11 (5A), U3.13 (6A), U4.1 (GND), U4.40 (GND), U4.41 (GND), U5.2 (GND), U5.6 (SDO)
unnamed: D1.2 (A), F1.2
unnamed: D3.2 (A), R3.2
unnamed: D4.2 (A), R4.2
unnamed: J1.2 (IR), R5.1, R7.1
unnamed: J1.3 (RX_TAP), R10.1
unnamed: J1.4 (TX_TAP), R12.1
unnamed: Q1.3 (D), R7.2
unnamed: Q1.1 (G), R8.1, R9.1
unnamed: C13.1, Q2.1 (B), R10.2, R11.1
unnamed: Q2.3 (C), R16.1, U3.3 (2A)
unnamed: C3.1, U1.6 (BST)
unnamed: C3.2, L1.1, U1.5 (SW)
unnamed: C12.1, R5.2, R6.1, U3.1 (1A)
unnamed: C14.1, R12.2, R13.1, U3.5 (3A)
unnamed: R3.1, U4.23 (IO21)

Notes on the sheet:
1) 12 V INPUT + BUCK 12 V -> 5 V
+12V and GND come from the Gree board LOGIC side through J1 (+12V pad and 'GND', never 'GND/'). F1 limits fault current into the Gree 12 V rail; D1 blocks back-feed when the board is powered from J5.
2) 5 V -> 3.3 V LDO
D2 lets J5 (USB-UART adapter 5 V) power the board on the bench. The 5 V rail only feeds the LDO (all level shifting runs at 3.3 V).
4) IR LINE + BUS TAPS (5 V -> 3.3 V)
J1 (one 5-pin JST XH, 2.50 mm, shared ground) on the Gree indoor board LOGIC side: 1 +12V 2 IR data line (5 V) 3 RX tap: U6 opto output, pin 4 (0.10 V / 1.07 V); the 5 V MCU RX line also works 4 TX tap: Gree board's TX opto (its U3) drive node, logic side 5 GND ('GND', never 'GND/') IR line and TX 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
3) ESP32-S3-WROOM-1-N16R8
ESP32: used pins sit on the side facing their circuit; every other GPIO is left open (NC flags). Strapping pins IO0/IO3/IO45/IO46: only IO0 is used (BOOT button). IO35/IO36/IO37 MUST stay unconnected: the octal PSRAM of the N16R8 uses them internally.
5) I2C: BME280 on the board + J3 for more sensors
U5: GY-BME280 breakout soldered at the bottom-right board edge, on a slotted island without copper pour, away from the regulators and the ESP32. Address 0x76 (SDO low). J3: more I2C sensors on a cable (3V3 GND SCL SDA).
PROGRAMMING (3.3 V-logic USB-UART)
Labels connect by name to the same labels at the ESP32 and D2.
Hold BOOT, tap RESET to flash. Adapter RX -> pin 3, TX -> pin 4. After the first flash use OTA.

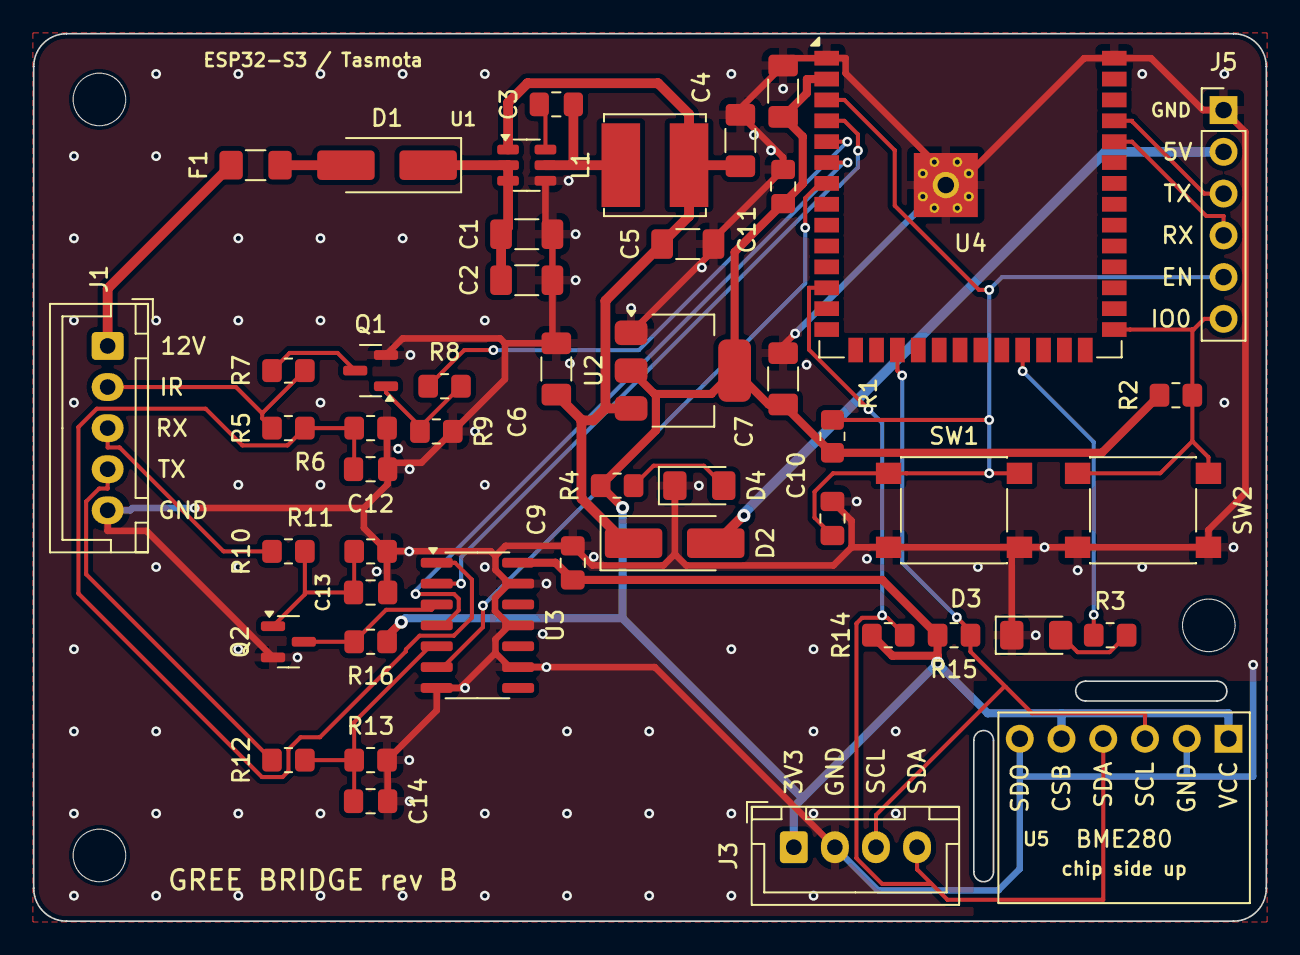
[picture p22: board gree_bridge.kicad_pcb from above]

Board: 2 copper layers, 75.0 x 54.0 mm, 51 parts (0 on the bottom side), 31 nets.

Other parts of the board:
H1, H2, H3: M3; MountingHole_3.2mm_M3
