reparationchlorinateur/gree-bridge/(commit log)

2026-10-18 Gree bridge rev B: hardware, firmware, Home Assistant files and docs
    ESP32-S3 board for Gree mini-split indoor units (tested on GWH12KF /
    GRJ819-A3): IR control on the unit's own IR line, listen-only taps on the
    indoor/outdoor bus, BME280. Tasmota 15.6.0 build plus Berry scripts,
    Home Assistant package generator, Apple Home via Matter, KiCad project,
    Gerbers and JLCPCB assembly files, install and safety notes.
    Claude-Session: https://claude.ai/code/session_018wFvMfpKdbreL2fe7KXygz
    [bom.csv, bom_jlcpcb.csv, bom_jlcpcb_with_connectors.csv, gree_bridge.kicad_pcb, gree_bridge.kicad_sch, gree_bridge_revB_positions_kicad.csv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]
2026-10-18 Add the 3D-printable case (not printed yet)
    PETG case for the rev B board: base, lid and J5 cap, STL in print
    orientation, STEP for CAD, OpenSCAD source generated from the KiCad
    board, fit check (308 checks pass) and renders.
    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
    [gree_base.step, gree_base.stl, gree_cap.step, gree_cap.stl, gree_case.scad, gree_case_assembly.step, gree_case_params.scad, gree_lid.step]
2026-10-18 Docs: photo of the RX/TX tap points and hot side on the GRJ819-A3 board
    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
2026-10-18 Gree tools (IR brand, bus speed detection, captures) and a Claude Skill
    - firmware/tasmota/gree_tools.be (new, optional): "Gree tools" page and
    commands IrDetect, BusDetect [apply], GreeCapture, GreeMark
    - gree_bus.be: pause/resume, frame hooks, BusSerial (default 600 8E1, so
    Gree units are unchanged)
    - autoexec.be loads gree_tools.be when it is on the board
    - host tests: gree_tools (simulated UART lines, sampling loop, IR,
    captures, web page) and an integration test with gree_bus.be
    - docs/adapting.md: fitting the board to other units and brands
    - .claude/skills/gree-bridge + skill/gree-bridge.zip: Claude Skill with a
    capture analysis script (Python, standard library only)
    Not yet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
2026-10-18 Docs and Skill: fixes from a trial run of the Skill
    - 3.3 V logic but 5 V supply on J5, stated in the install guide
    - BME280 rows only when the breakout is fitted
    - Gree U3/U6 named as Gree board parts, one wording for the TX tap
    - tap points valid for GRJ819-A3; other boards and fixed-speed units
    - Gree rows appear about 30 s after power-up
    - Skill: pictures included, one-evening plan, script path
    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
2026-10-18 Skill and tools: fixes from the capture-decoding trial run
    - analyze_capture.py: bytes already drifting before an event (and the
    checksum) are no longer attributed to it; new timeline section with
    every byte change, also the unexplained ones; several capture files
    at once; temperature readings for constant bytes too
    - BusDetect also reports the gaps between bursts (ms)
    - adapting guide: download each capture, start-up mode that starts the
    compressor in any weather, BusGap note, one-coincidence warning
    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
2026-10-18 gree_tools: IR line noise no longer starts a start-up capture; stable model
    Found on the first board test (gree_chambre): with the unit off, short
    UNKNOWN codes (3 bits) appear on the IR line and armed the start-up
    capture too early. Only a decoded AC command (wall remote) or a command
    sent by the board starts it now; noise is counted apart. The decoder's
    model guess varies between presses (YBOFB / YAW1F): the most frequent one
    is shown and flash is written only when it changes.
    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
2026-10-18 Real start-up capture from a GWH12KF, tested on the first board
    gree_tools.be (IR brand detection, BusDetect, captures, start-up sequence)
    tested on the first board in a GWH12KF: brand GREE detected, BusDetect
    found RX 600 8E1 inverted / TX 600 8E1 normal with 0 errors and a 53 ms
    reply gap, captures and the start-up sequence work, Home Assistant and
    Apple Home unaffected, 93 KB heap free with Matter on.
    - docs/captures/gwh12kf_startup_heat.txt: real start-up in heat, also
    the Skill's example; what it shows is in docs/protocol.md
    - IR line noise and the varying model guess documented
    Claude-Session: https://claude.ai/code/session_01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
2026-10-18 Case rev 2: snap-fit lid, board screwed to the base
    - The board is held by 3 x M3 x 6 pan head screws into the base bosses
    (4.4 mm of thread, the back stays closed; M3 x 8 would be too long).
    - The lid has no screw holes or clamp columns any more and sits on the
    wall top. 3 cantilever snap latches (back, front, right) click into
    windows in the base walls: 1.84 % peak strain, 0.3 mm preload against
    rattle, released with a small screwdriver through each window.
    - BOOT key redesigned for the new tolerance stack (stem gap 0.14 to
    1.06 mm over PCB +/-10 %, so the lid never holds BOOT); RESET tube gap
    1.3 mm.
    - Fit check: 349 rows, all pass. New latch renders and sections.
    - docs/hardw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
    [gree_base.step, gree_base.stl, gree_cap.step, gree_cap.stl, gree_case.scad, gree_case_assembly.step, gree_case_params.scad, gree_lid.step]
2026-10-18 README: IR control works on most brands, the bus readout is Gree
    The intro now says the board fits a mini-split indoor unit in general:
    IR control through the unit's own IR receiver line works with any AC
    brand Tasmota's IR library knows; the indoor/outdoor bus is decoded and
    tested on a Gree GWH12KF only. The safety note says other brands have
    not been tried yet.
    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
2026-10-20 gree_bus: raw frames logged only on demand (BusLog 0|1, default off)
    Until now every frame was turned into a hex string and a log line,
    even when nobody looked at the log. With BusLog 0 (the default) the
    script only counts and decodes frames; the hex is built for the web
    page when the page is drawn, and for BusPublish when that is on.
    BusLog 1 writes every frame to the console at INFO level. Tests added;
    docs and the Skill updated.
    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
2026-11-07 Newer Gree bus (protocol B, 1200 baud) decoded; Willis MGW12KCH15S photos
    gree_bus.be (2026-11-07) also decodes the 1200 baud 8E1 bus found on Gree-built
    Willis MGW12KCH15S/I units (2015, indoor board 30148875): groups of four 20-byte
    frames, checksum = sum of bytes 0-18, temperatures in whole degrees + 40.
    Indoor 31 20 and outdoor 31 10 frames fill the same fields as the original
    decoder (Room, Coil, Setpoint, Mode, Fan, CompHz, CompA, PowerW, OutAir,
    OutCoil, DischC, ...), so the Home Assistant package and Apple Home need no
    change. Off frames carry no mode and always read 25 C: the last mode and
    setpoint are kept. Compressor current scale (0.1 A per count) is assumed.
    gree_tools.be: BusD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
2026-11-07 gree_tools.be: fix strict-mode load error; run the tests in strict mode
    The protocol B frame counter declared a variable 'i' that clashes with the one
    in the loop below it. Tasmota compiles Berry in strict mode, so the 2026-11-07
    gree_tools.be did not load on the boards (no Gree tools page, no BusDetect),
    while the host tests, run without -s, passed. Variables renamed; the README
    now runs every test with "berry -s", which catches this.
    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
2026-11-07 Third Gree bus decoded (protocol C: 600 baud, 20/29-byte frames)
    Found on another older Gree unit: same line and XOR checksum rule as the
    GWH12KF, but longer frames (indoor 06 .. 0E, 20 bytes; outdoor 05 .. 0B,
    29 bytes). Mapped from one 10-minute capture with every command sent by IR
    from the board (heat, setpoints, fan speeds, cool, dry, fan, auto, off):
    room and setpoint are value x 2 + 48, coil and outdoor temperatures use the
    protocol A NTC curves, power/mode as protocol A's b3, compressor Hz, running
    mode and load bytes as before. gree_bus.be 2026-11-07b decodes it into the
    same fields; gree_tools.be 2026-11-07b counts these frames in BusDetect; the
    analysis script decodes them. Captur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
2026-11-07 slot_bus.be (experimental): reader for one-bit-per-mains-cycle buses
    Older Toshiba / Carrier indoor units (found on a RAS-15LKV-UL) do not use a
    UART between indoor and outdoor: in each 60 Hz cycle the line carries a
    6.6 ms pulse (bit 1) or nothing (bit 0), and the bits form 8N1 characters at
    one bit per cycle, in 6-byte frames. slot_bus.be polls the tap pins from the
    fast loop, counts mains cycles between pulses, rebuilds the characters and
    hands the frames to the same hooks as gree_bus.be (so GreeCapture records
    them). Host-tested on a simulated line (test_slot_bus.be). Marked
    experimental: on the board the fast loop runs only 70-130 times a second, so
    some pulses are missed; decoding of t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
2026-11-07 Remove slot_bus.be: not Gree (moved out of this repository)
    The mains-synchronous bus reader was written for a Toshiba unit; this
    repository keeps only the Gree bridge.
    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
2026-11-08 Home Assistant docs: card with power/humidity/pressure, display per room, louvre position
    - A built-in-cards example (thermostat + entities stack) besides the HACS one.
    - Display on/off per room: every command carries the last display state;
    default_light_mode decides it after a restart ("Off" for a bedroom).
    - Fixed louvre positions with a dropdown helper and the tasmota-irhvac vane
    blueprint, and repointing such automations when an old IR board is replaced.
    Learned on four units on 2026-11-07.
    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
2026-11-08 JLCPCB-assembled boards verified working
    Boards assembled by JLCPCB from hardware/jlcpcb/ (with the U1 rotation and U4
    position fixes) all worked first time; four are in service since 2026-11-07.
    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
2026-11-08 Multi-split support (protocol B port address) and vertical louvre helper
    - gree_bus.be: protocol B frames carry the head's port on a multi-split outdoor
    unit in the low nibble of b1 (31 21 / 31 11 on port 1, 0 on a single split);
    match the high nibble only and skip the extra 40 1x outdoor frame. Tested on a
    2-head Gree multi-split (YAW1F remote): link OK, protocol B, values match.
    - docs/protocol.md: multi-split section with the measured frames.
    - gree_room_template.yaml: input_select <room>_vertical + automation sending the
    picked louvre position (tasmota_irhvac.set_swingv).
    Claude-Session: https://claude.ai/code/session_01AGf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
    [gree_room_template.yaml]
2026-11-08 Multi-split: compressor current from the 40 1p frame, fan speed low nibble
    - Outdoor: multi-split units send an extra 40 1p frame; b3 repeats the
    compressor frequency and b7 reads 0 stopped, 6-7 at 57 Hz heating. Used as the
    compressor current (1 A per count, assumed until checked with a clamp meter),
    so CompA/PowerW work on multi-splits (b7 of 31 1p stays 0 there).
    - Indoor: multi-split heads send b4 = 0x20 + fan stage (1 min, 2 medium,
    3 max, 4 turbo); take the low nibble (single splits send the stage alone).
    Claude-Session: https://claude.ai/code/session_01AGf8yUQnmbxDGo1Qy4JV4C
2026-11-08 protocol.md: multi-split with two boards (port 2, shared outdoor values, mode conflict)
    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
2026-11-13 Apple Home: GreeMatter set-up command, room names, fan / dry / swing / turbo / sensors
    - gree_matter.be: `GreeMatter <room> [fr]` turns Matter on if needed, sets FriendlyName1
    (the bridge name the Home app keeps from pairing) to the room and writes the endpoints
    with the room in every name, so several boards in one house look different: thermostat,
    display, turbo, fan (v.Fan, Min/Medium/Max, off = Auto), dry mode (v.Relay, on = Dry,
    off = unit off), swing (v.Relay), BME280 temperature and humidity, outdoor temperature
    (Gree#OutAir). The fan, dry and swing tiles are sent as IRhvac (full last state, one
    thing changed). `GreeMatterPair 0/1` closes / opens the pairing window, to pair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
2026-11-13 install.md: Apple Home tiles grouped (Show as Separate Tiles) and clean re-pairing
    Checked on the first board (Chambre): paired with the ten endpoints from GreeMatter;
    the Home app grouped them in one tile until Show as Separate Tiles was turned on.
    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
2026-11-13 gree_matter.be: GreeMatter on a board with Matter off
    Tasmota creates matter_device even while SetOption151 is off, so the script now treats
    Matter as on only when SetOption151 is 1 (GreeMatter then turns it on, restarts and
    writes the endpoints after the restart). Found on the second board; 55 host tests pass.
    Deployed on four boards (Chambre, Diner, Salon, Sous-sol).
    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
2026-11-13 Protocol B: defrost decoded (outdoor b15 = 2), Defrost field and HA binary sensor
    A whole defrost cycle captured on a Willis MGW12KCH15S/I heating at about -2 C outside
    (docs/captures/protocol_b_defrost.txt): outdoor b15 reads 02 from the start of defrost
    until the compressor restarts in heat (00 in normal heat); meanwhile the indoor coil goes
    down to -19 C with the indoor fan stopped and indoor b12 00, the outdoor coil warms from
    -8 to +16 C at 85 Hz and the outdoor "air" byte reads up to +17 C. About 7-8 minutes.
    - gree_bus.be 2026-11-13: "Defrost" true/false in the Gree JSON (null on protocols A and
    C, which do not tell yet), published at once when it changes, "(defrost)" on the main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
2026-11-13 install.md: GreeMatter keeps an existing pairing
    Run on two boards already paired with Apple Home (a two-head multi-split): both kept their
    pairings and got the new endpoints, with the defrost-aware gree_bus.be.
    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
